jlpoltrack/SimpleCANBreakoutMicro/production/bom.csv

Designator | Footprint | Quantity | Value | LCSC Part #
C1, C4, C5 | 0603 | 3 | 1u
C2, C3, C6 | 0603 | 3 | 100n
J1 | PinHeader_1x04_P2.54mm_Vertical | 1 | Conn_01x04_Pin
J2 | JST_GH_SM04B-GHS-TB_04x1.25mm_Angled | 1 | Conn_01x04_Pin | C189895
R1 | 0603 | 1 | 120
U2 | SOT-23-3 | 1 | XC6206PxxxMR | C5446
U3 | SOIC-8_3.9x4.9mm_P1.27mm | 1 | SN65HVD230 | C12084
