jlpoltrack/SimpleCANBreakoutMicro/SimpleCANBreakoutMicro.pdf

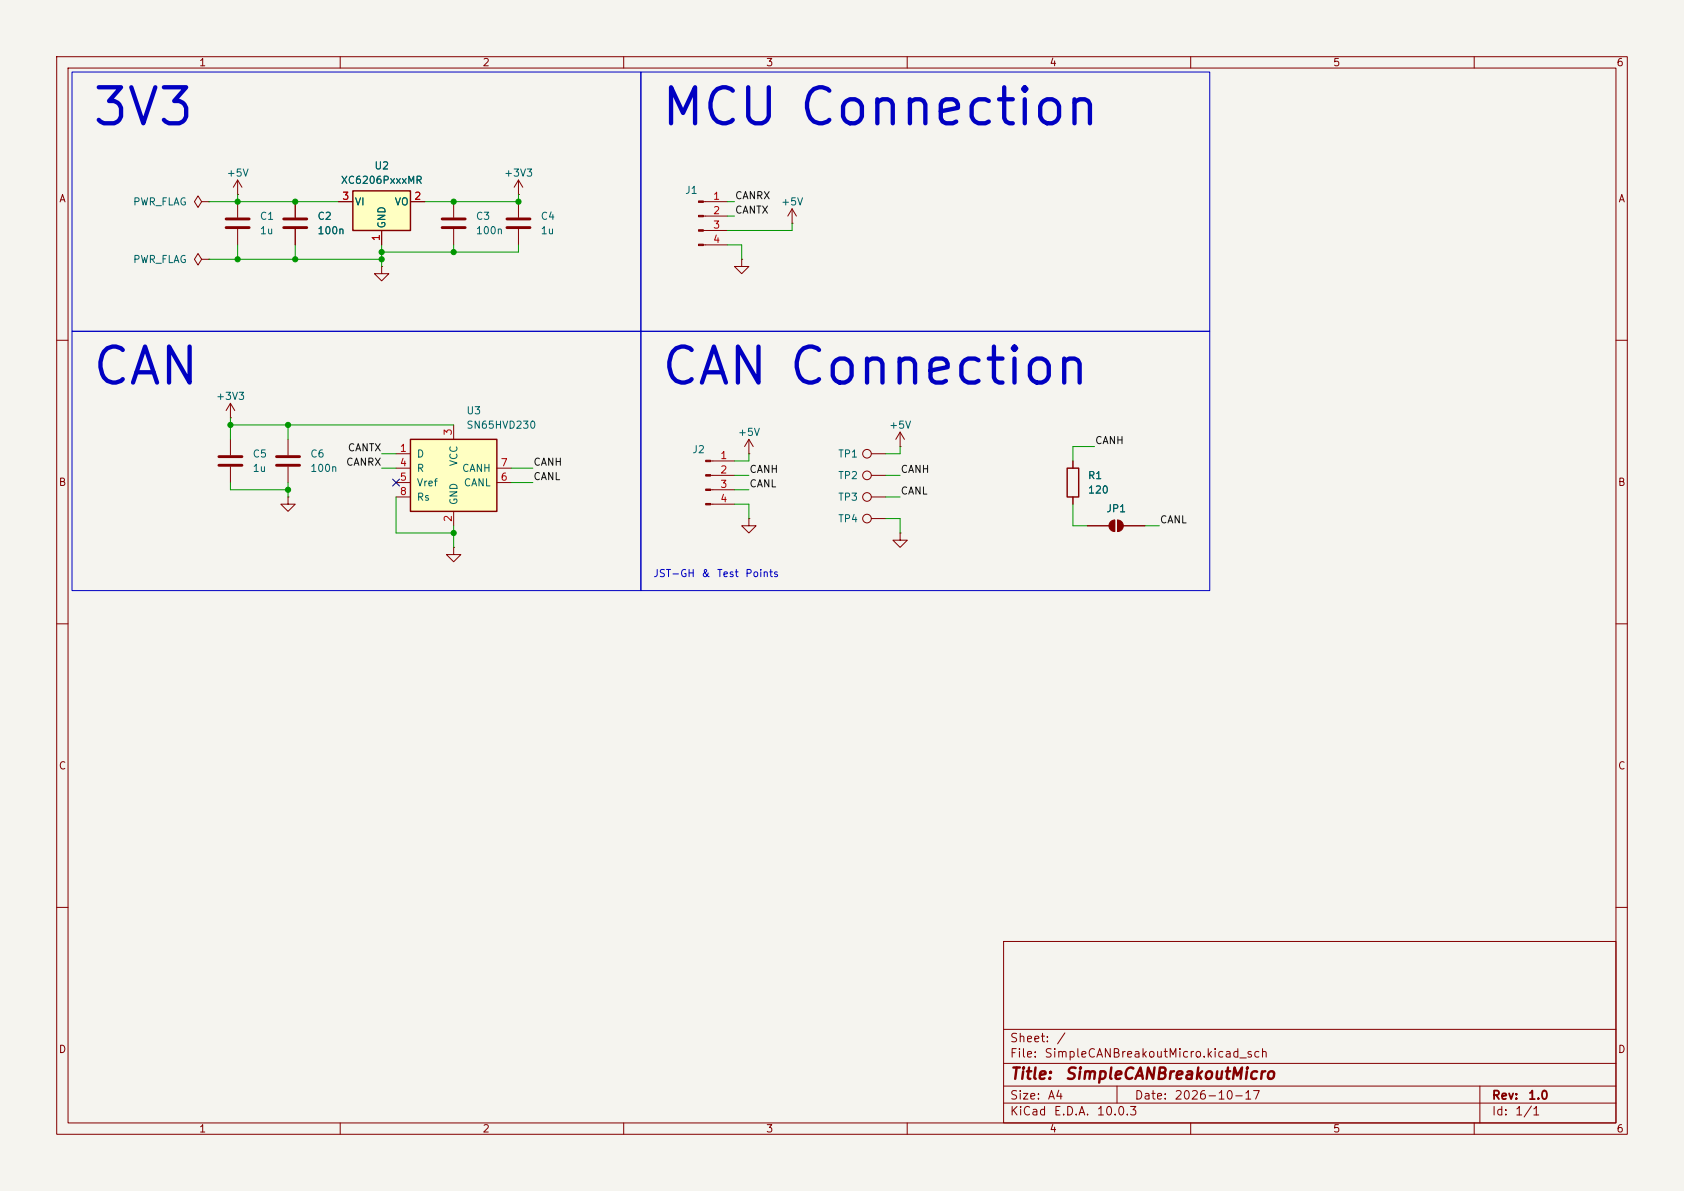
[picture p3: page 1]

JST-GH & Test Points 3V3

MCU Connection 1 3 4

CANTX CANRX CANL CANH

CAN Connection 4

Size: A4 | Rev: 1.0
KiCad E.D.A. 10.0.3 | Id: 1/1
