jlpoltrack/SimpleCANBreakoutMicro/SimpleCANBreakoutMicro.kicad_pcb

## KiCad design SimpleCANBreakoutMicro.kicad_pcb (2026-10-13)

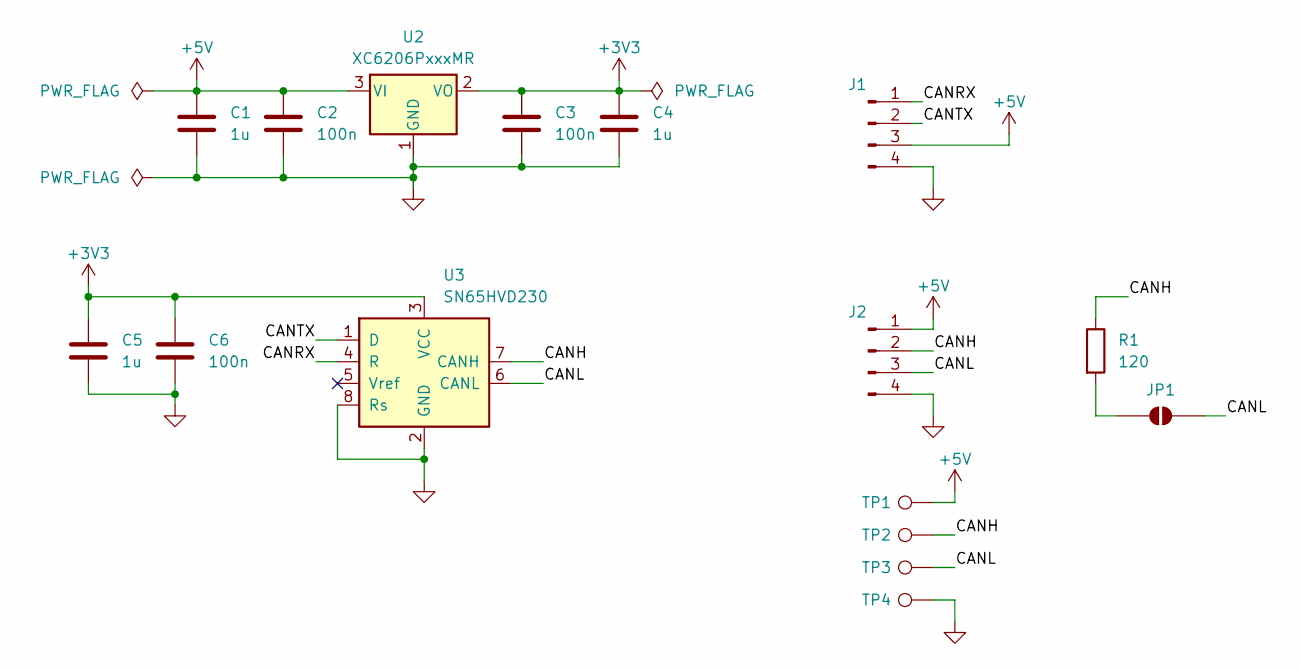
[picture p4: schematic SimpleCANBreakoutMicro.kicad_sch]

Parts:
C1, C4, C5: 1u; C_0603_1608Metric
C2, C3, C6: 100n; C_0603_1608Metric
J1: Conn_01x04_Pin; PinHeader_1x04_P2.54mm_Vertical
J2: Conn_01x04_Pin; JST_GH_SM04B-GHS-TB_04x1.25mm_Angled; LCSC Part C189895
JP1: SolderJumper_2_Open; SolderJumper-2_P1.3mm_Open_RoundedPad1.0x1.5mm
R1: 120; R_0603_1608Metric
TP1, TP2, TP3, TP4: TestPoint; TestPoint_Pad_1.0x1.0mm
U2: XC6206PxxxMR; SOT-23-3; LCSC Part C5446
U3: SN65HVD230; SOIC-8_3.9x4.9mm_P1.27mm; LCSC Part C12084

Connections:
+3V3: C3.1, C4.1, C5.1, C6.1, U2.2 (VO), U3.3 (VCC)
+5V: C1.1, C2.1, J1.3, J2.1, TP1.1 (1_1), U2.3 (VI)
/CANH: J2.2, R1.1, TP2.1 (1_1), U3.7 (CANH)
/CANL: J2.3, JP1.2 (B), TP3.1 (1_1), U3.6 (CANL)
/CANRX: J1.1, U3.4 (R)
/CANTX: J1.2, U3.1 (D)
GND: C1.2, C2.2, C3.2, C4.2, C5.2, C6.2, J1.4, J2.4, TP4.1 (1_1), U2.1 (GND), U3.2 (GND), U3.8 (Rs)
unnamed: JP1.1 (A), R1.2

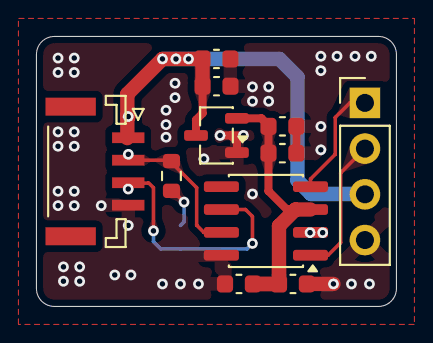
[picture p5: board SimpleCANBreakoutMicro.kicad_pcb from above]

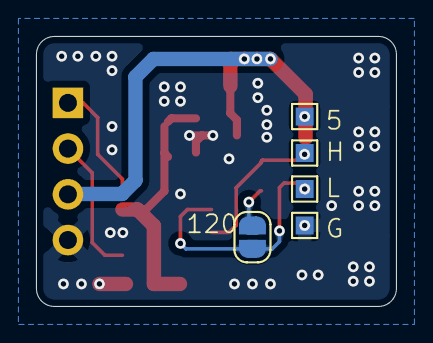
[picture p6: board SimpleCANBreakoutMicro.kicad_pcb from below]

Board: 2 copper layers, 20.0 x 15.0 mm, 16 parts (5 on the bottom side), 8 nets.
