jlpoltrack/SimpleCANBreakoutMicro/(commit log)

2026-10-11 Initial commit: KiCad project, production files, and README
    [SimpleCANBreakoutMicro.kicad_pcb, SimpleCANBreakoutMicro.kicad_sch, bom.csv, designators.csv, positions.csv]
2026-10-11 Add board render to README
2026-10-13 Add bottom pads, silkscreen
    [SimpleCANBreakoutMicro.kicad_pcb, SimpleCANBreakoutMicro.kicad_sch]
2026-10-17 Add Schematic
    [SimpleCANBreakoutMicro.kicad_sch]
2026-10-17 Replace render with KiCad front and back renders
2026-10-18 Schematic title block (title, date, rev 1.0); PDF re-exported
    [SimpleCANBreakoutMicro.kicad_sch]
2026-10-18 Schematic: headings aligned in their boxes, CAN heading off the border (sch_tidy.py)
    [SimpleCANBreakoutMicro.kicad_sch]
2026-10-18 Schematic: drop redundant PWR_FLAG on +3V3 (U2 VO already drives it) - ERC clean
    [SimpleCANBreakoutMicro.kicad_sch]
2026-10-24 README: drop board dimensions and the 2-layer note; match USBGPIB-STM32's layout
